venkataanil22/A-Voice-Controlled-Anti-collision-Robot/Readme.txt

Randon Stasney, Aditya Pawar, Venkata Anil Viswanadha, Brandon Biodrowski 544 Final Project
All original files have been included including reused IP from project 2  
The Video link for the accelerometer and signals can be found at
Project Additions: https://youtu.be/WpCXBphi_Qg
