venkataanil22/A-Voice-Controlled-Anti-collision-Robot/design_1.pdf

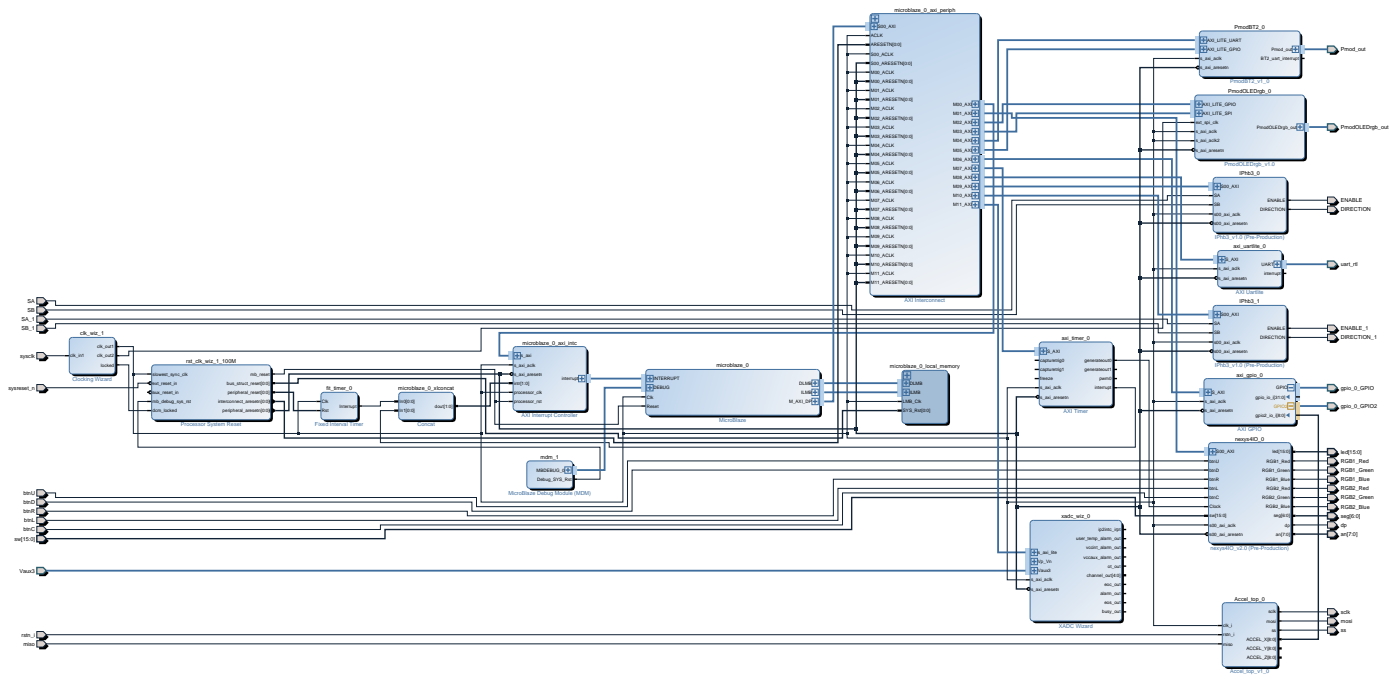
[picture p8: page 1]
Accel_top_0; Accel_top_v1_0; clk_i; rstn_i; sclk mosi; miso; ss ACCEL_X[8:0] ACCEL_Y[8:0] ACCEL_Z[8:0]; DIRECTION; DIRECTION_1; ENABLE; ENABLE_1; IPhb3_0; IPhb3_v1.0 (Pre-Production); S00_AXI SA; ENABLE DIRECTION; s00_axi_aclk; s00_axi_aresetn; IPhb3_1; PmodBT2_0; PmodBT2_v1_0; Pmod_out; AXI_LITE_UART AXI_LITE_GPIO; s_axi_aclk; BT2_uart_interrupt s_axi_aresetn; PmodOLEDrgb_out; PmodOLEDrgb_0; PmodOLEDrgb_v1.0; AXI_LITE_GPIO; AXI_LITE_SPI; PmodOLEDrgb_out ext_spi_clk; s_axi_aclk2; s_axi_aresetn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

Processor System Reset

Fixed Interval Timer

AXI Interrupt Controller

MicroBlaze Debug Module (MDM)
