venkataanil22/A-Voice-Controlled-Anti-collision-Robot/bitmap.h

/************************************************************************/
/*																		*/
/*	bitmap.h	--	A bitmap stored as a byte array, used on OLEDrgb	*/
/*																		*/
/************************************************************************/
/*	Author: 	Thomas Kappenman										*/
/*  Modified by Randon Stasney											*/
/************************************************************************/
/*  Module Description: 												*/
/*																		*/
/*	This module contains a bitmap file that has been converted to a		*/
/*	byte array using a python script									*/
/*	This script can be found at:										*/
/*			github.com/tom21091/Bmp-to-byte-array-script				*/
/*																		*/
/************************************************************************/
/*  Revision History:													*/
/*																		*/
/*	02/08/2016(TommyK): created											*/
/*  02/01/2017 Modified for Amelie bitmap								*/
/*																		*/
/************************************************************************/

const uint8_t tommy[12288] ={
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
};
